GadgetReboot/ESP32_Breakout/README.md

# ESP32_Breakout
ESP32 module breakout board
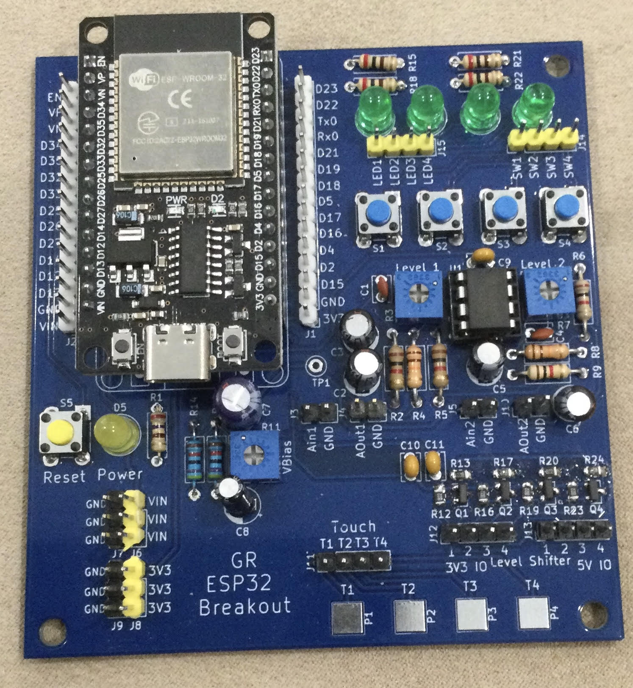
[picture p1: Assembled_PCB.jpg]
PCB
<br><br><br><br>
