GadgetReboot/ESP32_Breakout/sketch/readme.md

Demo sketch to control LEDs with touch pads, buttons, or level shifter inputs
