GadgetReboot/ESP32_Breakout/ESP32Breakout_Sch.pdf

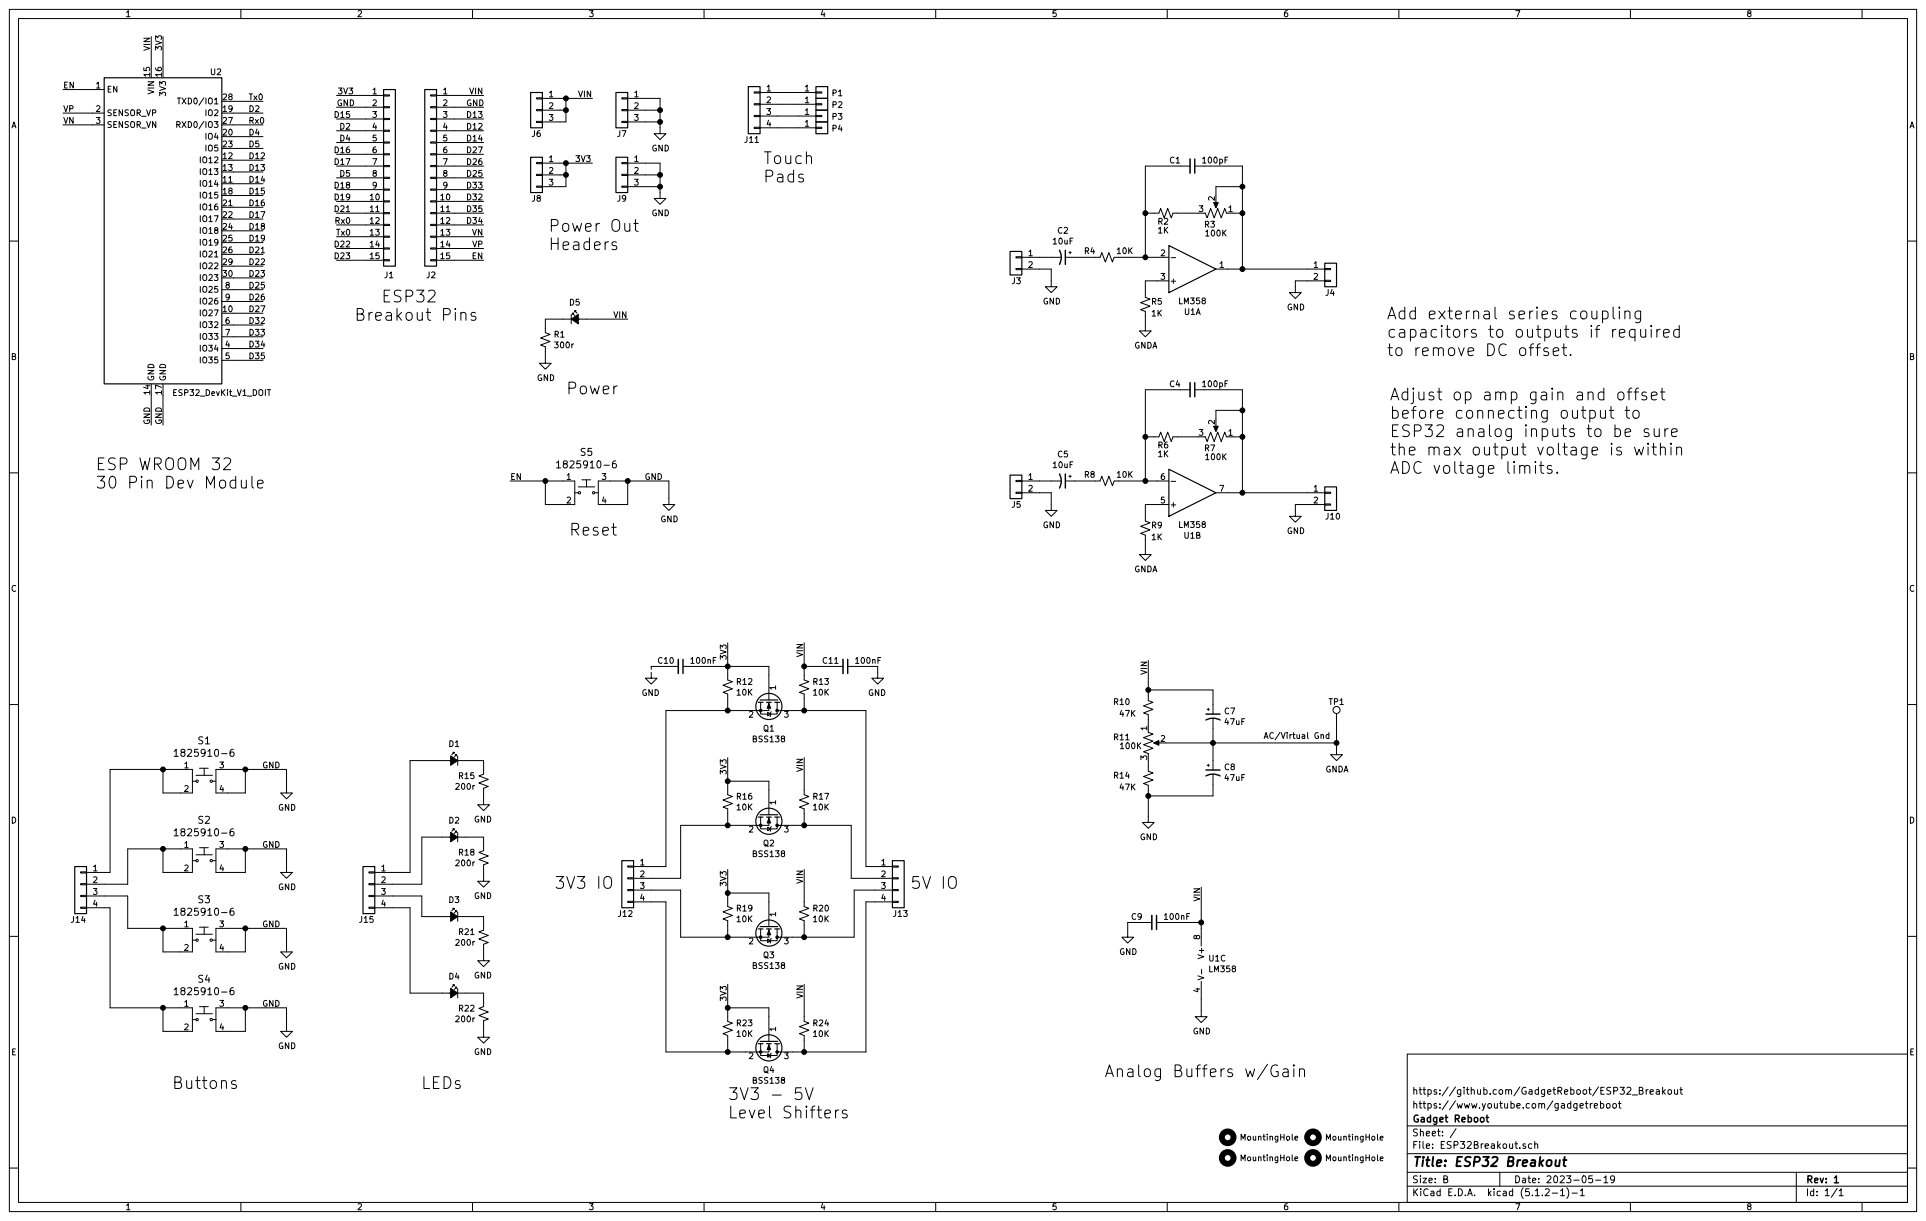
[picture p2: page 1]

capacitors to outputs if required
to remove DC offset.

Adjust op amp gain and offset
before connecting output to
ESP32 analog inputs to be sure
the max output voltage is within
ADC voltage limits.

https://www.youtube.com/gadgetreboot
Id: 1/1 Title: ESP32 Breakout File: ESP32Breakout.sch Sheet: / Gadget Reboot
