GadgetReboot/ESP32_Breakout/KiCad/ESP32Breakout.kicad_pcb

## KiCad design KiCad/ESP32Breakout.kicad_pcb (2023-05-21)

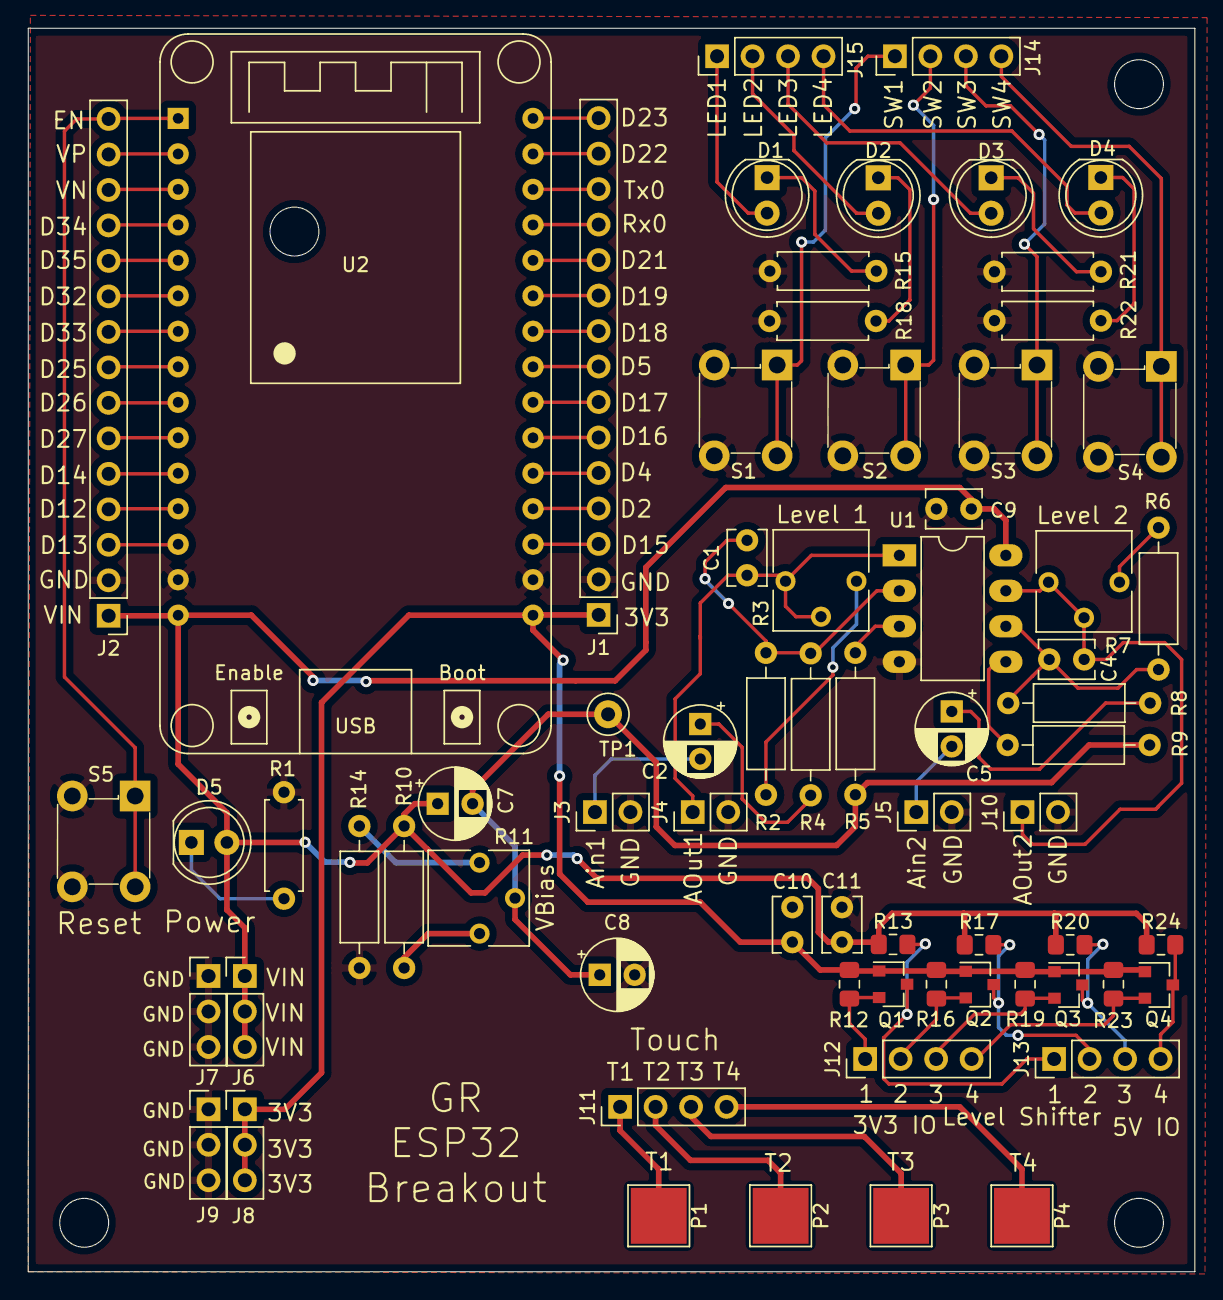
[picture p3: board ESP32Breakout.kicad_pcb from above]

Board: 2 copper layers, 83.5 x 89.0 mm, 73 parts (0 on the bottom side), 69 nets.

Parts:
C1, C4: 100pF; C_Disc_D3.8mm_W2.6mm_P2.50mm
C2, C5: 10uF; CP_Radial_D5.0mm_P2.50mm
C7, C8: 47uF; CP_Radial_D5.0mm_P2.50mm
C9, C10, C11: 100nF; C_Disc_D3.8mm_W2.6mm_P2.50mm
D1, D2, D3, D4, D5: LED_Small_ALT; LED_D5.0mm_Clear
H1, H2, H3, H4: MountingHole; MountingHole_3.5mm
J1, J2: Conn_01x15; PinHeader_1x15_P2.54mm_Vertical
J3, J4, J5, J10: Conn_01x02; PinHeader_1x02_P2.54mm_Vertical
J6, J7, J8, J9: UART; PinHeader_1x03_P2.54mm_Vertical
J11, J12, J13, J14, J15: Conn_01x04; PinHeader_1x04_P2.54mm_Vertical
P1, P2, P3, P4: Conn_01x01; Touch_Pad_15x15mm
Q1, Q2, Q3, Q4: BSS138; SOT-23
R1: 300r; R_Axial_DIN0207_L6.3mm_D2.5mm_P7.62mm_Horizontal
R2, R5, R6, R9: 1K; R_Axial_DIN0207_L6.3mm_D2.5mm_P10.16mm_Horizontal
R3, R7, R11: 100K; Potentiometer_Vishay_T73YP_Vertical
R4, R8: 10K; R_Axial_DIN0207_L6.3mm_D2.5mm_P10.16mm_Horizontal
R10, R14: 47K; R_Axial_DIN0207_L6.3mm_D2.5mm_P10.16mm_Horizontal
R12, R13, R16, R17, R19, R20, R23, R24: 10K; R_0805_2012Metric_Pad1.15x1.40mm_HandSolder
R15, R18, R21, R22: 200r; R_Axial_DIN0207_L6.3mm_D2.5mm_P7.62mm_Horizontal
S1, S2, S3, S4, S5: 1825910-6; Switch_Tactile_THT_6x6mm
TP1: TestPoint; TestPoint_Loop_D1.80mm_Drill1.0mm_Beaded
U1: LM358; DIP-8_W7.62mm_LongPads
U2: ESP32_DevKit_V1_DOIT; esp32_devkit_v1_doit

Connections:
/3V3: C10.1, J1.1, J8.1, J8.2, J8.3, Q1.1, Q2.1, Q3.1, Q4.1, R12.1, R16.1, R19.1, R23.1, U2.16
/D2: J1.4, U2.19
/D4: J1.5, U2.20
/D5: J1.8, U2.23
/D12: J2.4, U2.12
/D13: J2.3, U2.13
/D14: J2.5, U2.11
/D15: J1.3, U2.18
/D16: J1.6, U2.21
/D17: J1.7, U2.22
/D18: J1.9, U2.24
/D19: J1.10, U2.25
/D21: J1.11, U2.26
/D22: J1.14, U2.29
/D23: J1.15, U2.30
/D25: J2.8, U2.8
/D26: J2.7, U2.9
/D27: J2.6, U2.10
/D32: J2.10, U2.6
/D33: J2.9, U2.7
/D34: J2.12, U2.4
/D35: J2.11, U2.5
/EN: J2.15, S5.1, S5.2, U2.1
/Rx0: J1.12, U2.27
/Tx0: J1.13, U2.28
/VIN: C7.1, C9.1, C11.2, D5.2, J2.1, J6.1, J6.2, J6.3, R10.1, R13.1, R17.1, R20.1, R24.1, U1.8, U2.15
/VN: J2.13, U2.3
/VP: J2.14, U2.2
GND: C8.2, C9.2, C11.1, J1.2, J2.2, J3.2, J4.2, J5.2, J7.1, J7.2, J7.3, J9.1, J9.2, J9.3, J10.2, R1.2, R14.2, R15.2, R18.2, R21.2, R22.2, S1.3, S1.4, S2.3, S2.4, S3.3, S3.4, S4.3, S4.4, S5.3, S5.4, U1.4, U2.14, U2.17
GNDA: C7.2, C8.1, R5.2, R9.2, R11.2, TP1.1
unnamed: C1.1, J4.1, R3.1, R3.2, U1.1
unnamed: C1.2, R2.1, R4.2, U1.2
unnamed: C2.1, R4.1
unnamed: C2.2, J3.1
unnamed: C4.1, J10.1, R7.1, R7.2, U1.7
unnamed: C4.2, R6.1, R8.2, U1.6
unnamed: C5.1, R8.1
unnamed: C5.2, J5.1
unnamed: D1.1, R15.1
unnamed: D1.2, J15.1
unnamed: D2.1, R18.1
unnamed: D2.2, J15.2
unnamed: D3.1, R21.1
unnamed: D3.2, J15.3
unnamed: D4.1, R22.1
unnamed: D4.2, J15.4
unnamed: D5.1, R1.1
unnamed: J11.1, P1.1
unnamed: J11.2, P2.1
unnamed: J11.3, P3.1
unnamed: J11.4, P4.1
unnamed: J12.1, Q1.2, R12.2
unnamed: J12.2, Q2.2, R16.2
unnamed: J12.3, Q3.2, R19.2
unnamed: J12.4, Q4.2, R23.2
unnamed: J13.1, Q1.3, R13.2
unnamed: J13.2, Q2.3, R17.2
unnamed: J13.3, Q3.3, R20.2
unnamed: J13.4, Q4.3, R24.2
unnamed: J14.1, S1.1, S1.2
unnamed: J14.2, S2.1, S2.2
unnamed: J14.3, S3.1, S3.2
unnamed: J14.4, S4.1, S4.2
unnamed: R2.2, R3.3
unnamed: R5.1, U1.3
unnamed: R6.2, R7.3
unnamed: R9.1, U1.5
unnamed: R10.2, R11.1
unnamed: R11.3, R14.1
